randrej/BlueWaffle/RenderedSchematicsAndPcbs/BlueWaffleV1.9alpha.pdf

A | B | C | D | E | F | G | H | J | K

0

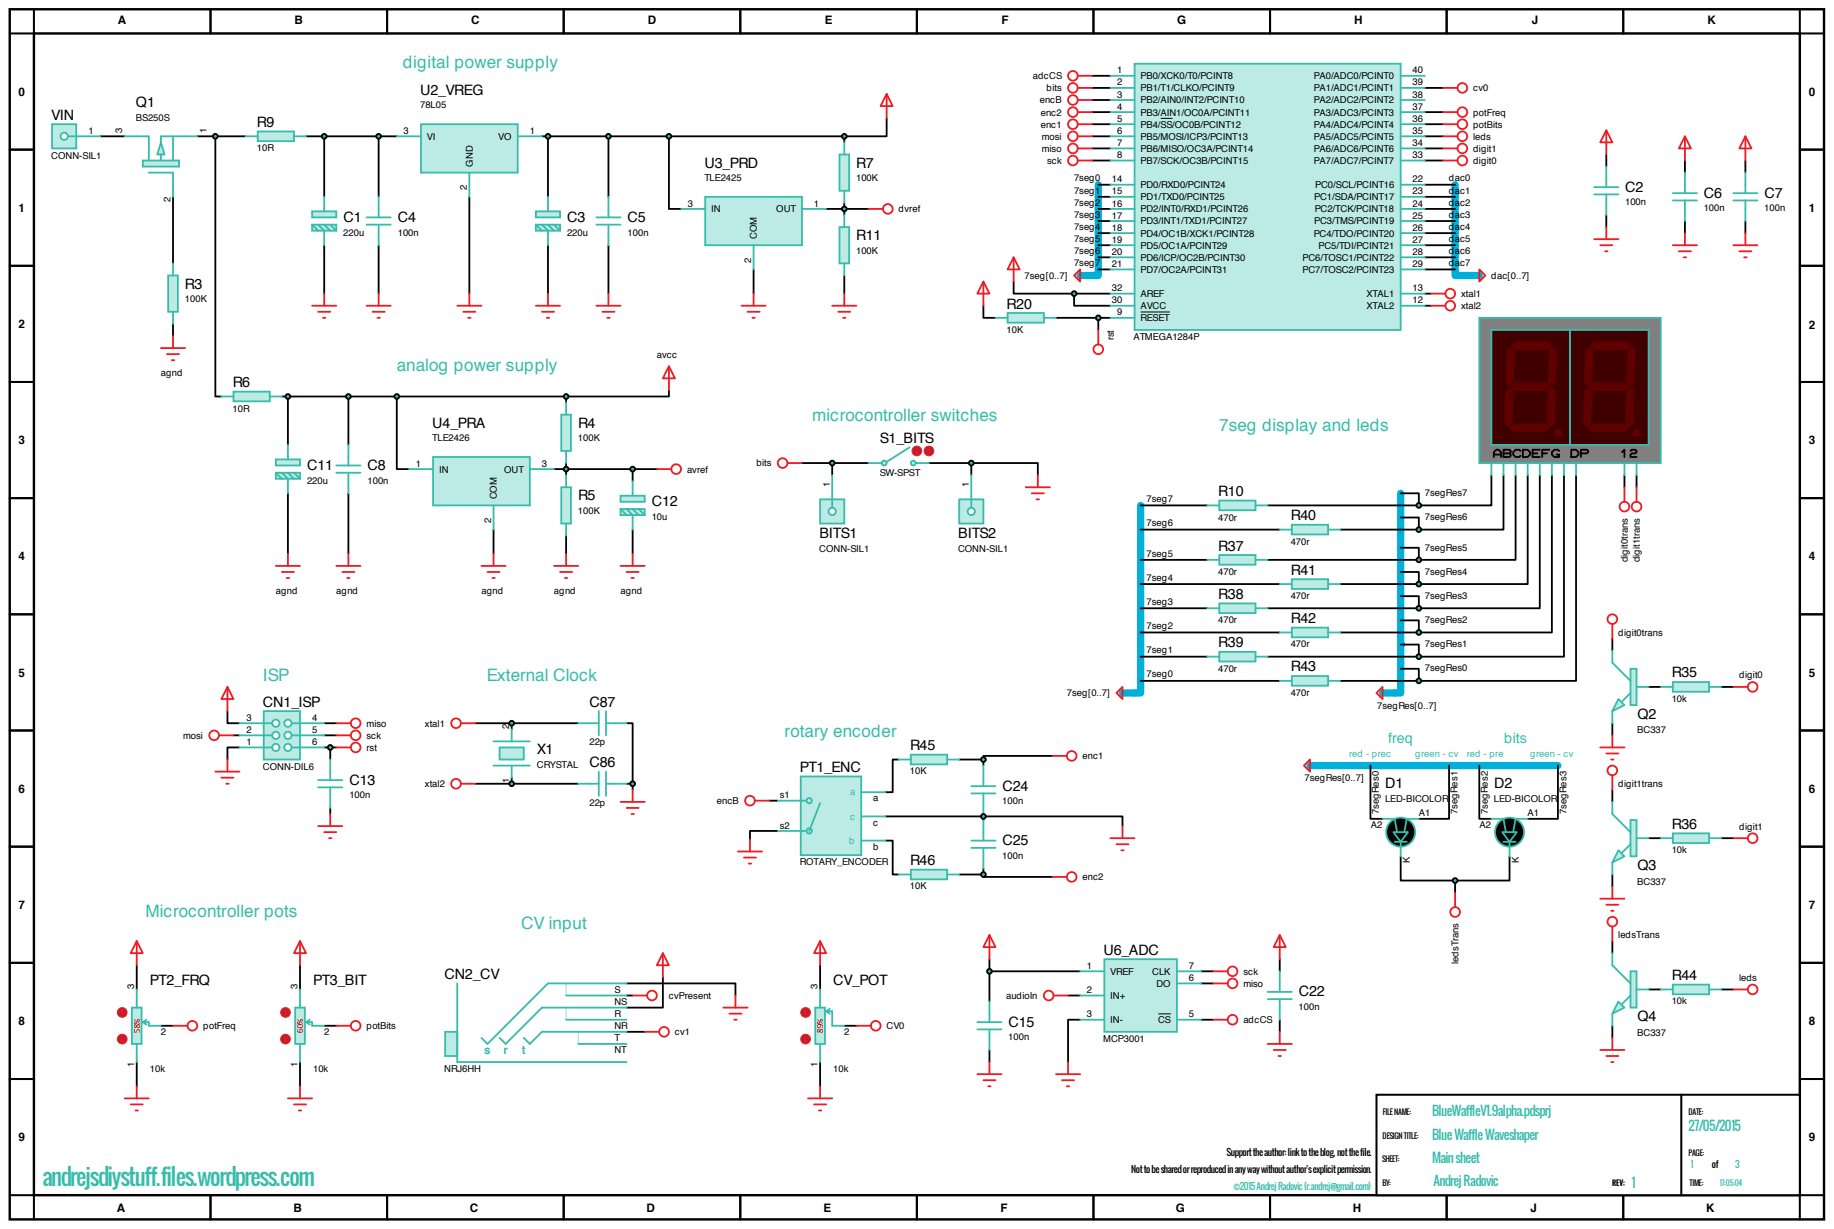
[picture p1: page 1]

andrejsdiystuff.files.wordpress.com

Support the author: link to the blog, not the file.

Not to be shared or reproduced in any way without author's explicit permission.

©2015 Andrej Radovic (r.andrej@gmail.com)

0

1

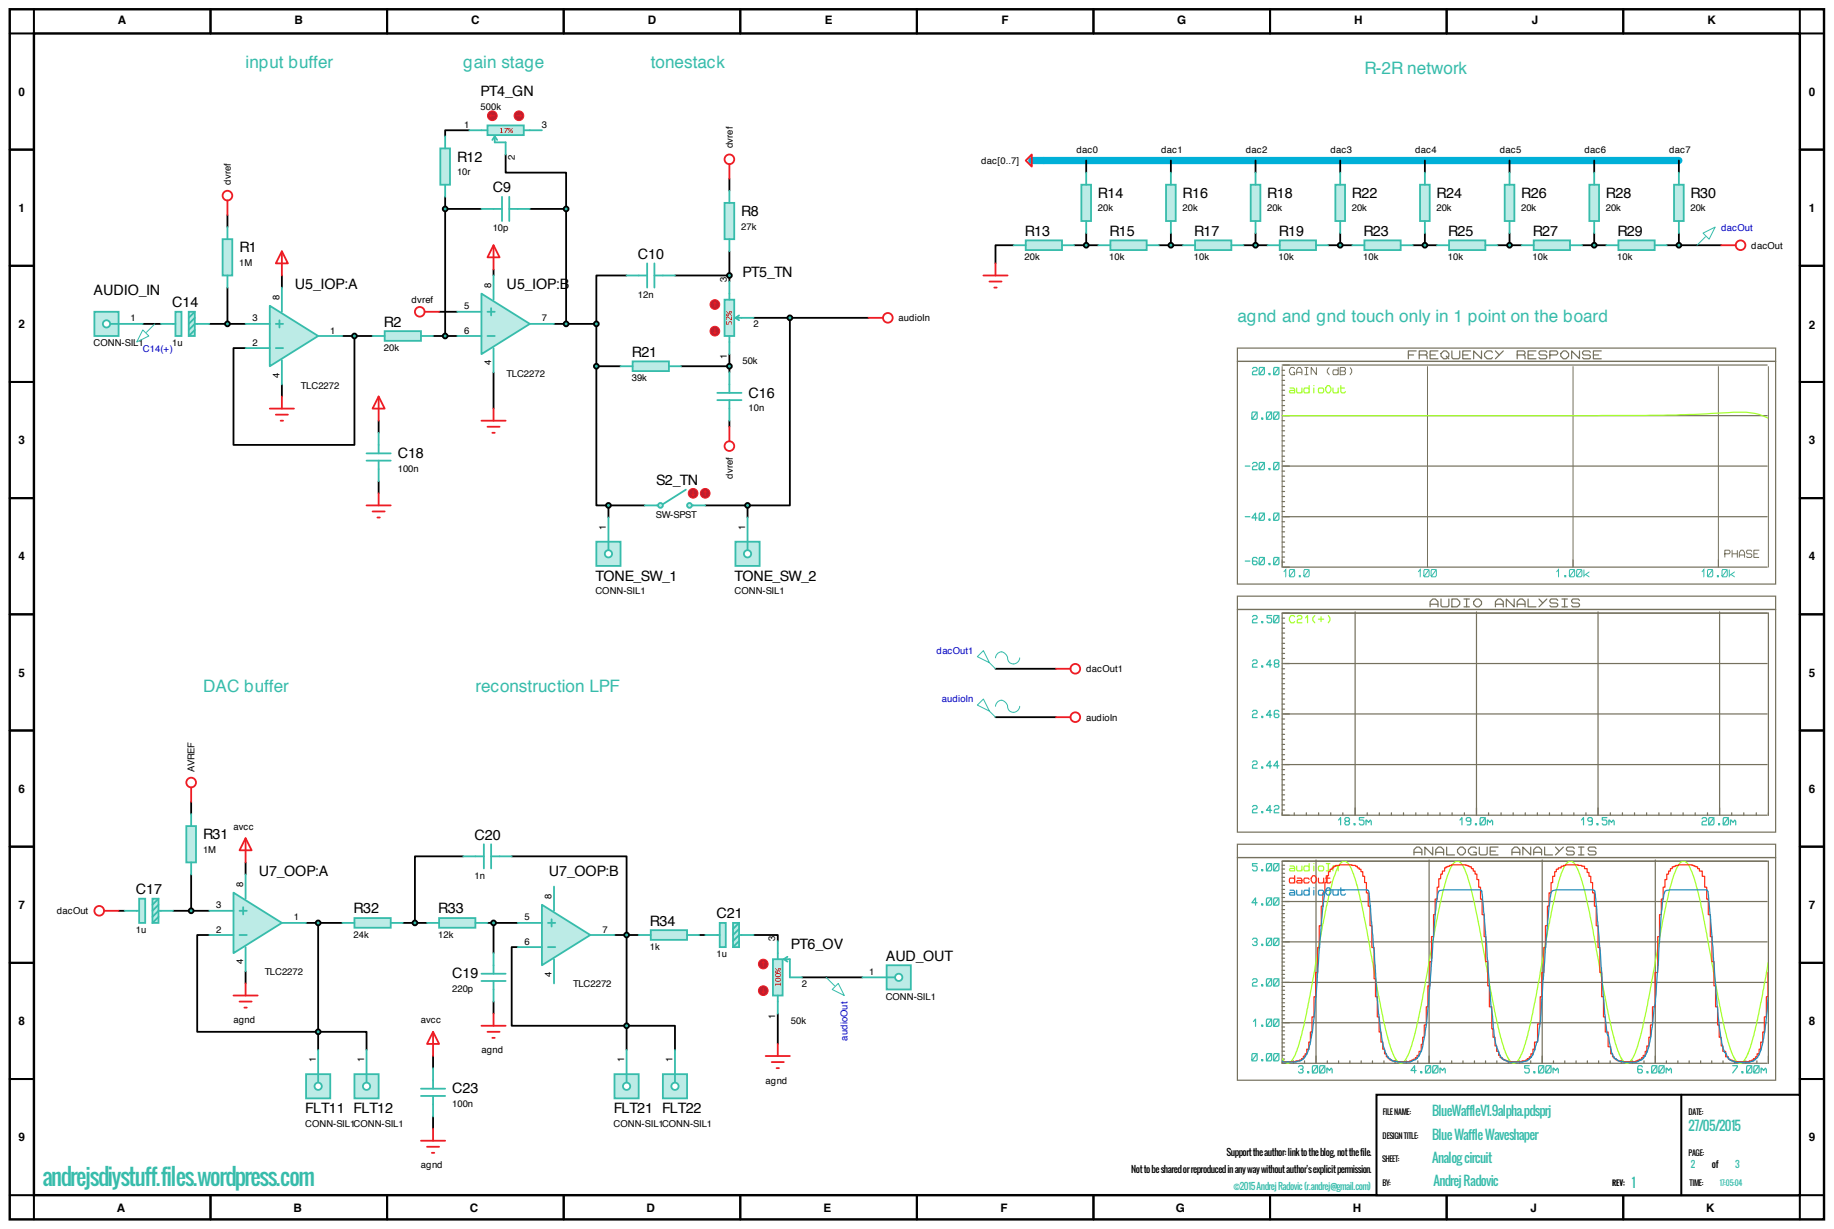
[picture p2: page 2]

agnd and gnd touch only in 1 point on the board

andrejsdiystuff.files.wordpress.com

Support the author: link to the blog, not the file.

Not to be shared or reproduced in any way without author's explicit permission.

©2015 Andrej Radovic (r.andrej@gmail.com)

0

1

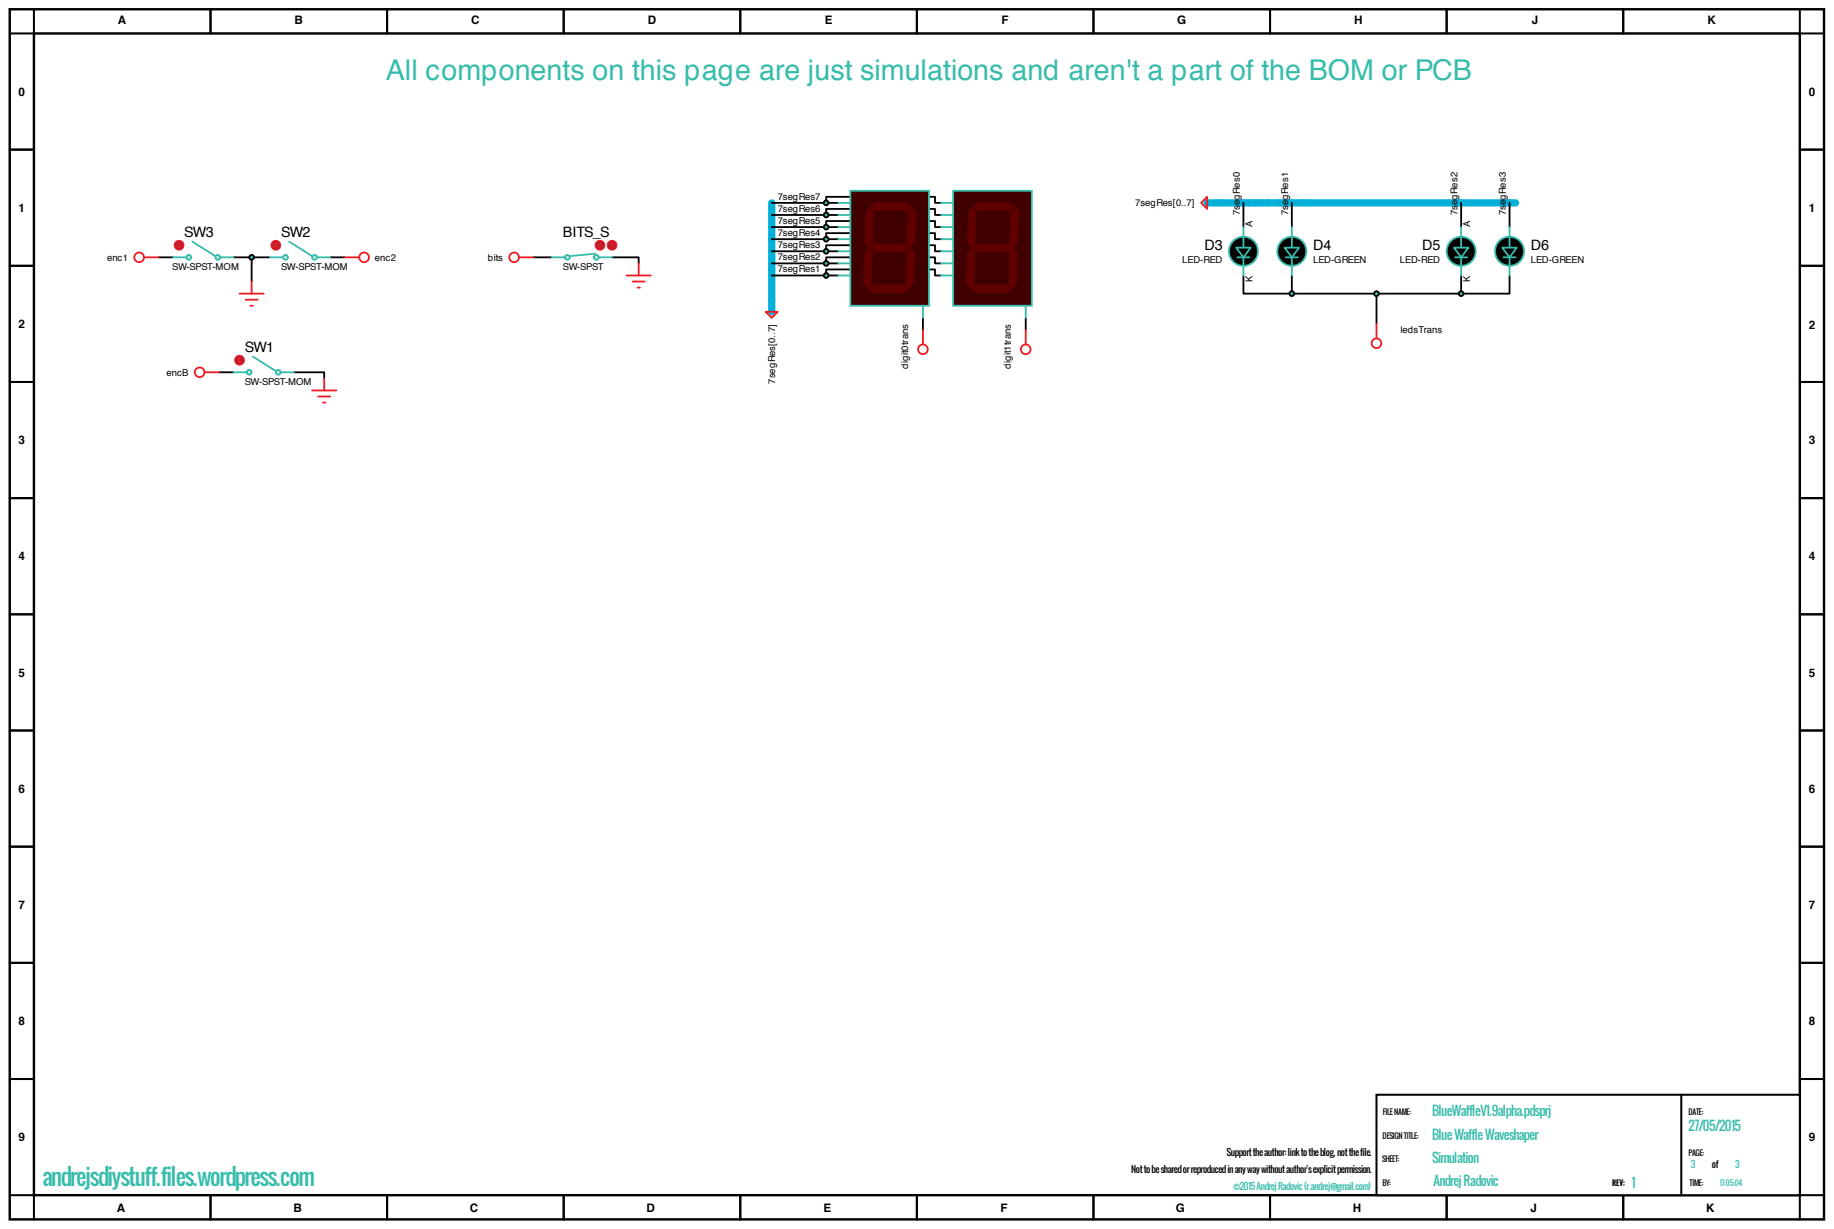
[picture p3: page 3]
FILE NAME:; DATE:; PAGE:; BlueWaffleV1.9alpha.pdsprj; Simulation; Andrej Radovic; SHEET:; REV: 1; TIME:; DESIGN TITLE:; Blue Waffle Waveshaper; 7segRes7 7segRes6 7segRes5 7segRes4 7segRes3 7segRes2 7segRes1; 7segRes0; 7segRes1; 7segRes2; 7segRes3; 7segRes[0..7]; digit0trans; digit1trans; ledsTrans; D3 LED-RED; LED-GREEN; D5 LED-RED; BITS_S; enc1; enc2

All components on this page are just simulations and aren't a part of the BOM or PCB

SW-SPST-MOM

SW-SPST bits

SW-SPST-MOM encB

andrejsdiystuff.files.wordpress.com

Support the author: link to the blog, not the file.

Not to be shared or reproduced in any way without author's explicit permission.

©2015 Andrej Radovic (r.andrej@gmail.com)
