randrej/BlueWaffle/(list of files, drawings)

Other design files:
BlueWaffleV1.9alpha.pdsprj
