randrej/BlueWaffle/Firmware/IOProcessor.c

#include "IOProcessor.h"

/*******************************************************************************
 *  public
 ******************************************************************************/
volatile uint8_t io_curr_pots[3];
volatile uint8_t io_curr_bits_sw;


/*******************************************************************************
 *  private
 ******************************************************************************/
const uint8_t io_greyToState[] PROGMEM = {0, 1, 3, 2};
const uint8_t io_nextState[] PROGMEM = {1, 2, 3, 0};
const uint8_t io_prevState[] PROGMEM = {3, 0, 1, 2};

volatile uint8_t io_curr_enc_state;

/*******************************************************************************
 *  implementation
 ******************************************************************************/

void io_init()
{
  // input states
  PC_SET_INPUT_PULLUP(PC_IO_ENC_BUTTON);
  PC_SET_INPUT_PULLUP(PC_IO_BITS_SWITCH);
  PC_SET_INPUT_PULLUP(PC_IO_ENC0);
  PC_SET_INPUT_PULLUP(PC_IO_ENC1);

  // read initial encoder state
  uint8_t encInp = IO_READ_ENCODER;
  encInp ^= 0b11;
  io_curr_enc_state = pgm_read_byte(&io_greyToState[encInp]);

  // read initial button statuses
  io_curr_bits_sw = PC_CHECK(PC_IO_BITS_SWITCH);

  // read initial pot values
  for (int i = 0; i < avrAdc_inputVector_length; ++i)
  {
    io_curr_pots[i] = avrAdc_inputVector[i];
  }

  modes_init();
}


void io_inputPoll()
{
  // encoder button handling
  if (!PC_CHECK(PC_IO_ENC_BUTTON))
  {
    // react immedeately (first trigger)
    modes_activeMode->buttonModeShortpressHandle();
    _delay_ms(IO_SHORT_DEBOUNCE_TIME);  // debounce

    while (!PC_CHECK(PC_IO_ENC_BUTTON))
      ;                                 // wait for release
    _delay_ms(IO_SHORT_DEBOUNCE_TIME);  // debounce
  }

  // bits switch handling
  if (PC_CHECK(PC_IO_BITS_SWITCH) != io_curr_bits_sw)
  {
    // react immedeately
    io_curr_bits_sw = PC_CHECK(PC_IO_BITS_SWITCH);
    modes_activeMode->switchBitsHandle();
    _delay_ms(IO_SHORT_DEBOUNCE_TIME);  // debounce
  }

  // encoder handling
  uint8_t enc = IO_READ_ENCODER;
  enc ^= 0b11;
  uint8_t encSt = pgm_read_byte(&io_greyToState[enc]);
  // if a state change is detected
  if (encSt != io_curr_enc_state)
  {
    // see if it's a change to the next state
    uint8_t next = pgm_read_byte(&io_nextState[io_curr_enc_state]);
    if (encSt == next)
    {
      io_curr_enc_state = encSt;
      modes_activeMode->encoderIncHandle();
      _delay_ms(IO_SHORT_DEBOUNCE_TIME);
      return;
    }

    // or a previous state
    uint8_t prev = pgm_read_byte(&io_prevState[io_curr_enc_state]);
    if (encSt == prev)
    {
      io_curr_enc_state = encSt;
      modes_activeMode->encoderDecHandle();
      _delay_ms(IO_SHORT_DEBOUNCE_TIME);
      return;
    }

    // if not, then this is a forbidden transition
    // we just note the current state, but don't trigger
    io_curr_enc_state = encSt;
  }


  // pot handling
  if (avrAdc_inputVector[AVR_ADC_INDEX_CV] != io_curr_pots[AVR_ADC_INDEX_CV])
  {
    io_curr_pots[AVR_ADC_INDEX_CV] = avrAdc_inputVector[AVR_ADC_INDEX_CV];
    modes_activeMode->potCVHandle();
  }
  if (avrAdc_inputVector[AVR_ADC_INDEX_FREQ] !=
      io_curr_pots[AVR_ADC_INDEX_FREQ])
  {
    io_curr_pots[AVR_ADC_INDEX_FREQ] = avrAdc_inputVector[AVR_ADC_INDEX_FREQ];
    modes_activeMode->potFreqHandle();
  }
  if (avrAdc_inputVector[AVR_ADC_INDEX_BITS] !=
      io_curr_pots[AVR_ADC_INDEX_BITS])
  {
    io_curr_pots[AVR_ADC_INDEX_BITS] = avrAdc_inputVector[AVR_ADC_INDEX_BITS];
    modes_activeMode->potBitsHandle();
  }
}
