randrej/BlueWaffle/Firmware/LedsAndDisplay.c

#include "LedsAndDisplay.h"
/*******************************************************************************
 *  Public
 ******************************************************************************/
volatile uint8_t lad_ledsArray[3];
uint8_t lad_flashPins[3] = {LAD_LEDS, LAD_DISPLAY_LSD, LAD_DISPLAY_MSD};


/*******************************************************************************
 *  Private
 ******************************************************************************/
volatile uint8_t lad_currentIndex;


/*******************************************************************************
 *  Progmem
 ******************************************************************************/
const uint8_t lad_decDigits[11] PROGMEM = {
  0b11111100, 0b01100000, 0b11011010, 0b11110010, 0b01100110, 0b10110110,
  0b10111110, 0b11100000, 0b11111110, 0b11110110, 0b10011111};

const uint8_t lad_hexDigits[16] PROGMEM = {
  0b11111100, 0b01100000, 0b11011010, 0b11110010, 0b01100110, 0b10110110,
  0b10111110, 0b11100000, 0b11111110, 0b11110110, 0b11101110, 0b111110,
  0b10011100, 0b1111010,  0b10011110, 0b10001110};

/*******************************************************************************
*  Implementation
******************************************************************************/
void lad_init()
{
  SETBITMASK(LAD_OUT_DIR, 0b11111111);
  SETBITMASK(LAD_PINS_DIR, LAD_PINS_MASK);
}

void lad_display_dec(uint8_t number)
{
  uint8_t MSDigit = number / 10;
  number -= MSDigit * 10;
  uint8_t LSDigit = number;

  lad_ledsArray[LAD_INDEX_LSD] = pgm_read_byte(&lad_decDigits[LSDigit]);
  lad_ledsArray[LAD_INDEX_MSD] = pgm_read_byte(&lad_decDigits[MSDigit]);
}

void lad_display_hex(uint8_t number)
{
  uint8_t MSDigit = number >> 4;
  number -= MSDigit << 4;
  uint8_t LSDigit = number;

  lad_ledsArray[LAD_INDEX_LSD] = pgm_read_byte(&lad_hexDigits[LSDigit]);
  lad_ledsArray[LAD_INDEX_MSD] = pgm_read_byte(&lad_hexDigits[MSDigit]);
}
