randrej/BlueWaffle/(commit log)

2015-05-24 Added the project's files
    [BlueWaffleV1.2c.pdsprj, BlueWaffleV1.6fc.pdsprj, BlueWaffleV1.6fc_bkp.pdsprj, BlueWaffleV1.7fc.pdsprj, BlueWaffleV1.7fcb.pdsprj, BlueWaffleV1.8fc.pdsprj, BlueWaffleV1.pdsprj]
2015-05-24 added missing encoder code
    [IOProcessor.c]
2015-05-25 general debugging - i wrote a bunch of code without testing
    [BlueWaffleV1.8fc.pdsprj]
2015-05-25 Fixed the obvious faults + modes
    Generated that const struct array for modes.
    [BlueWaffleV1.8fc.pdsprj]
2015-05-25 Going gold
    Added mode LED configurations.
    Fixed inputs - encoders, etc. Changed button/enc inputs to pullup, as
    they should have been.
    Set AVR ADC to be non-blocking.
    Changed wrong shift-lefts to shift-rights.
    Optimized display code.
    Good care about commits will be taken from now on. Until now, it made no
    sense, since the whole project was just a sketch.
    [BlueWaffleV1.8fc.pdsprj]
2015-05-26 Refactoring
    Renamed everything, eliminated fluff
    Added new readme info
    [BlueWaffleV1.2c.pdsprj, BlueWaffleV1.6fc.pdsprj, BlueWaffleV1.6fc_bkp.pdsprj, BlueWaffleV1.7fc.pdsprj, BlueWaffleV1.7fcb.pdsprj, BlueWaffleV1.8fc.pdsprj, BlueWaffleV1.9alpha.pdsprj, BlueWaffleV1.pdsprj]
2015-05-27 Renamed the parts so they are better organized on the BOM
    [BlueWaffleV1.9alpha.pdsprj]
2015-05-27 Uploaded the renamed BOM and schematic
    [BlueWaffleV1.9alpha.pdsprj]
2015-05-28 Swapped dac and led ports, for easier layout
    [LedsAndDisplay.h, spiAdc.c, spiAdc.h]
2015-05-28 Swapped dac and led ports
    [BlueWaffleV1.9alpha.pdsprj]
2015-05-28 replaced erroneous bus namesw
    [BlueWaffleV1.9alpha.pdsprj]
2015-05-28 Drew the packages for the display, encoder. Started layout.
    [BlueWaffleV1.9alpha.pdsprj]
